jackh1999/ECE445/notebooks/pdfs/ESP Menu Screens.pdf

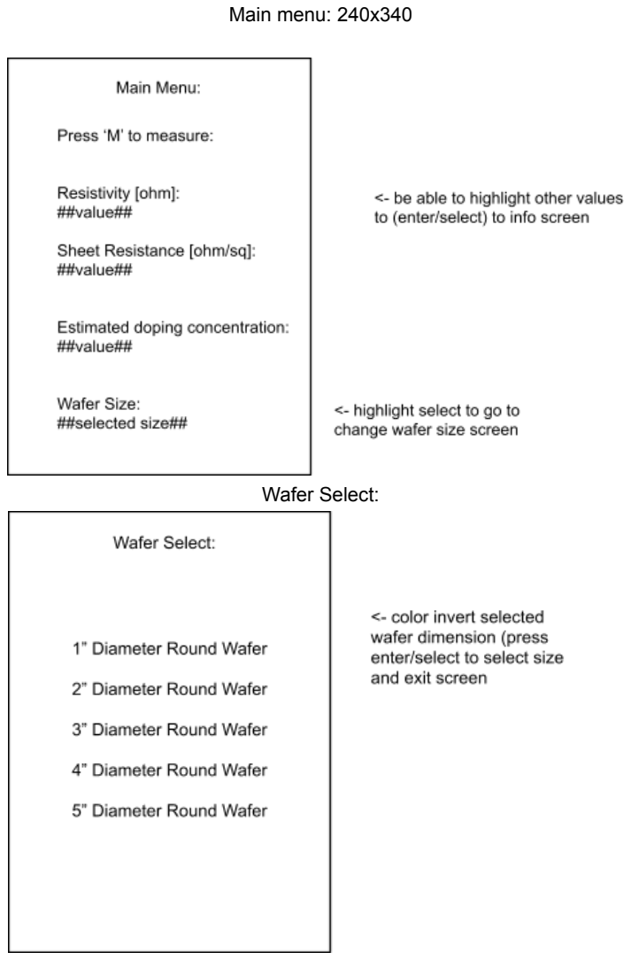
[picture p2: page 1]

Main menu: 240x340

Wafer Select:

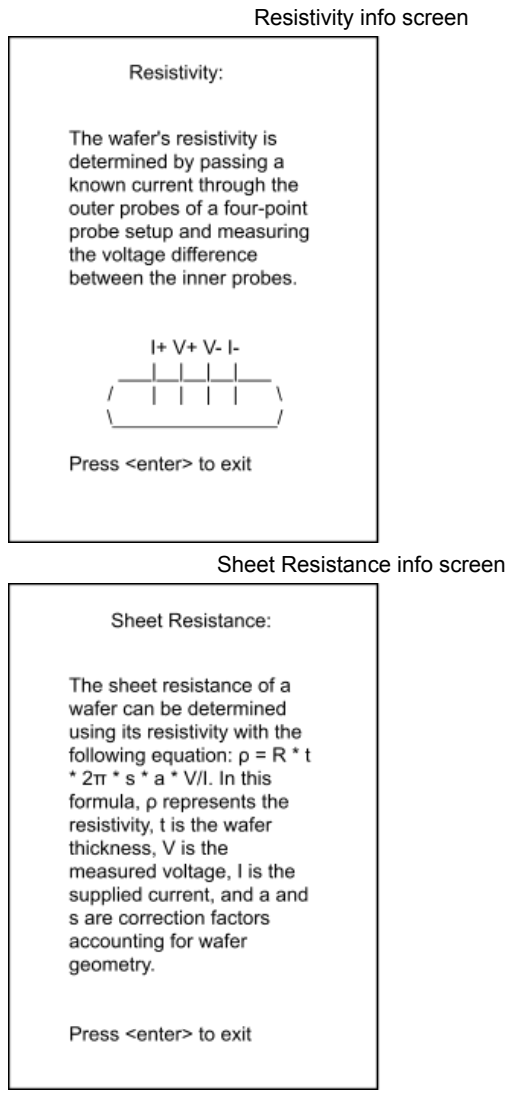
[picture p3: page 2]

Resistivity info screen

Sheet Resistance info screen

Estimated Doping Concentration:

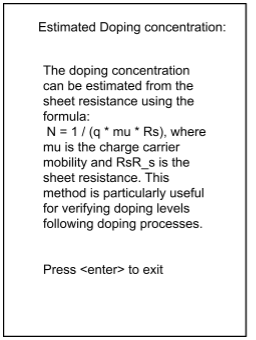
[picture p4: figure]
