jackh1999/ECE445/boards/PCB Round 1/FPP_10_8/FPP_10_8.kicad_pcb

## KiCad design boards/PCB Round 1/FPP_10_8/FPP_10_8.kicad_pcb (2024-12-03)

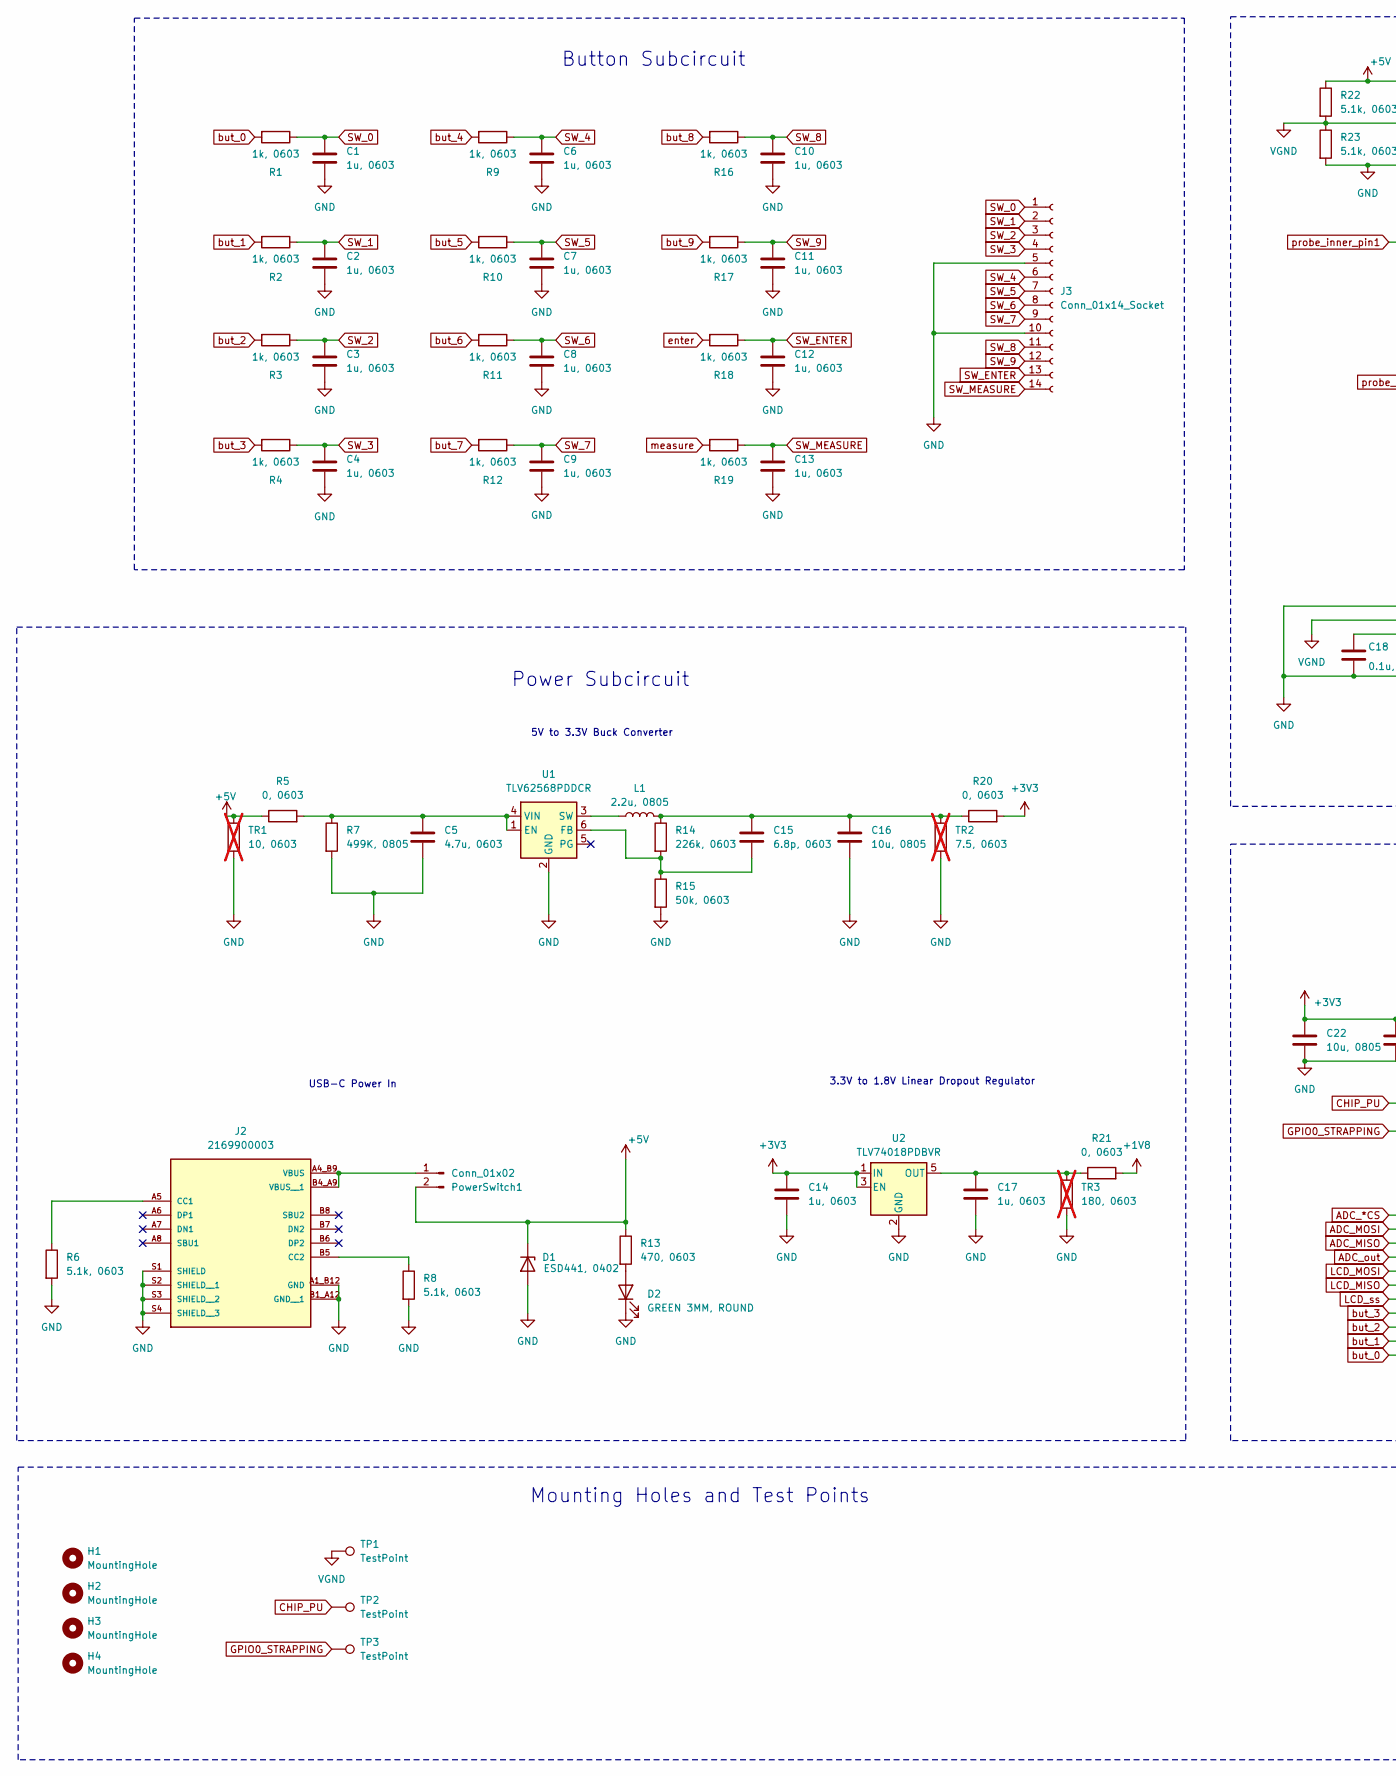
[picture p5: schematic FPP_10_8.kicad_sch, part in row 1, column 1]

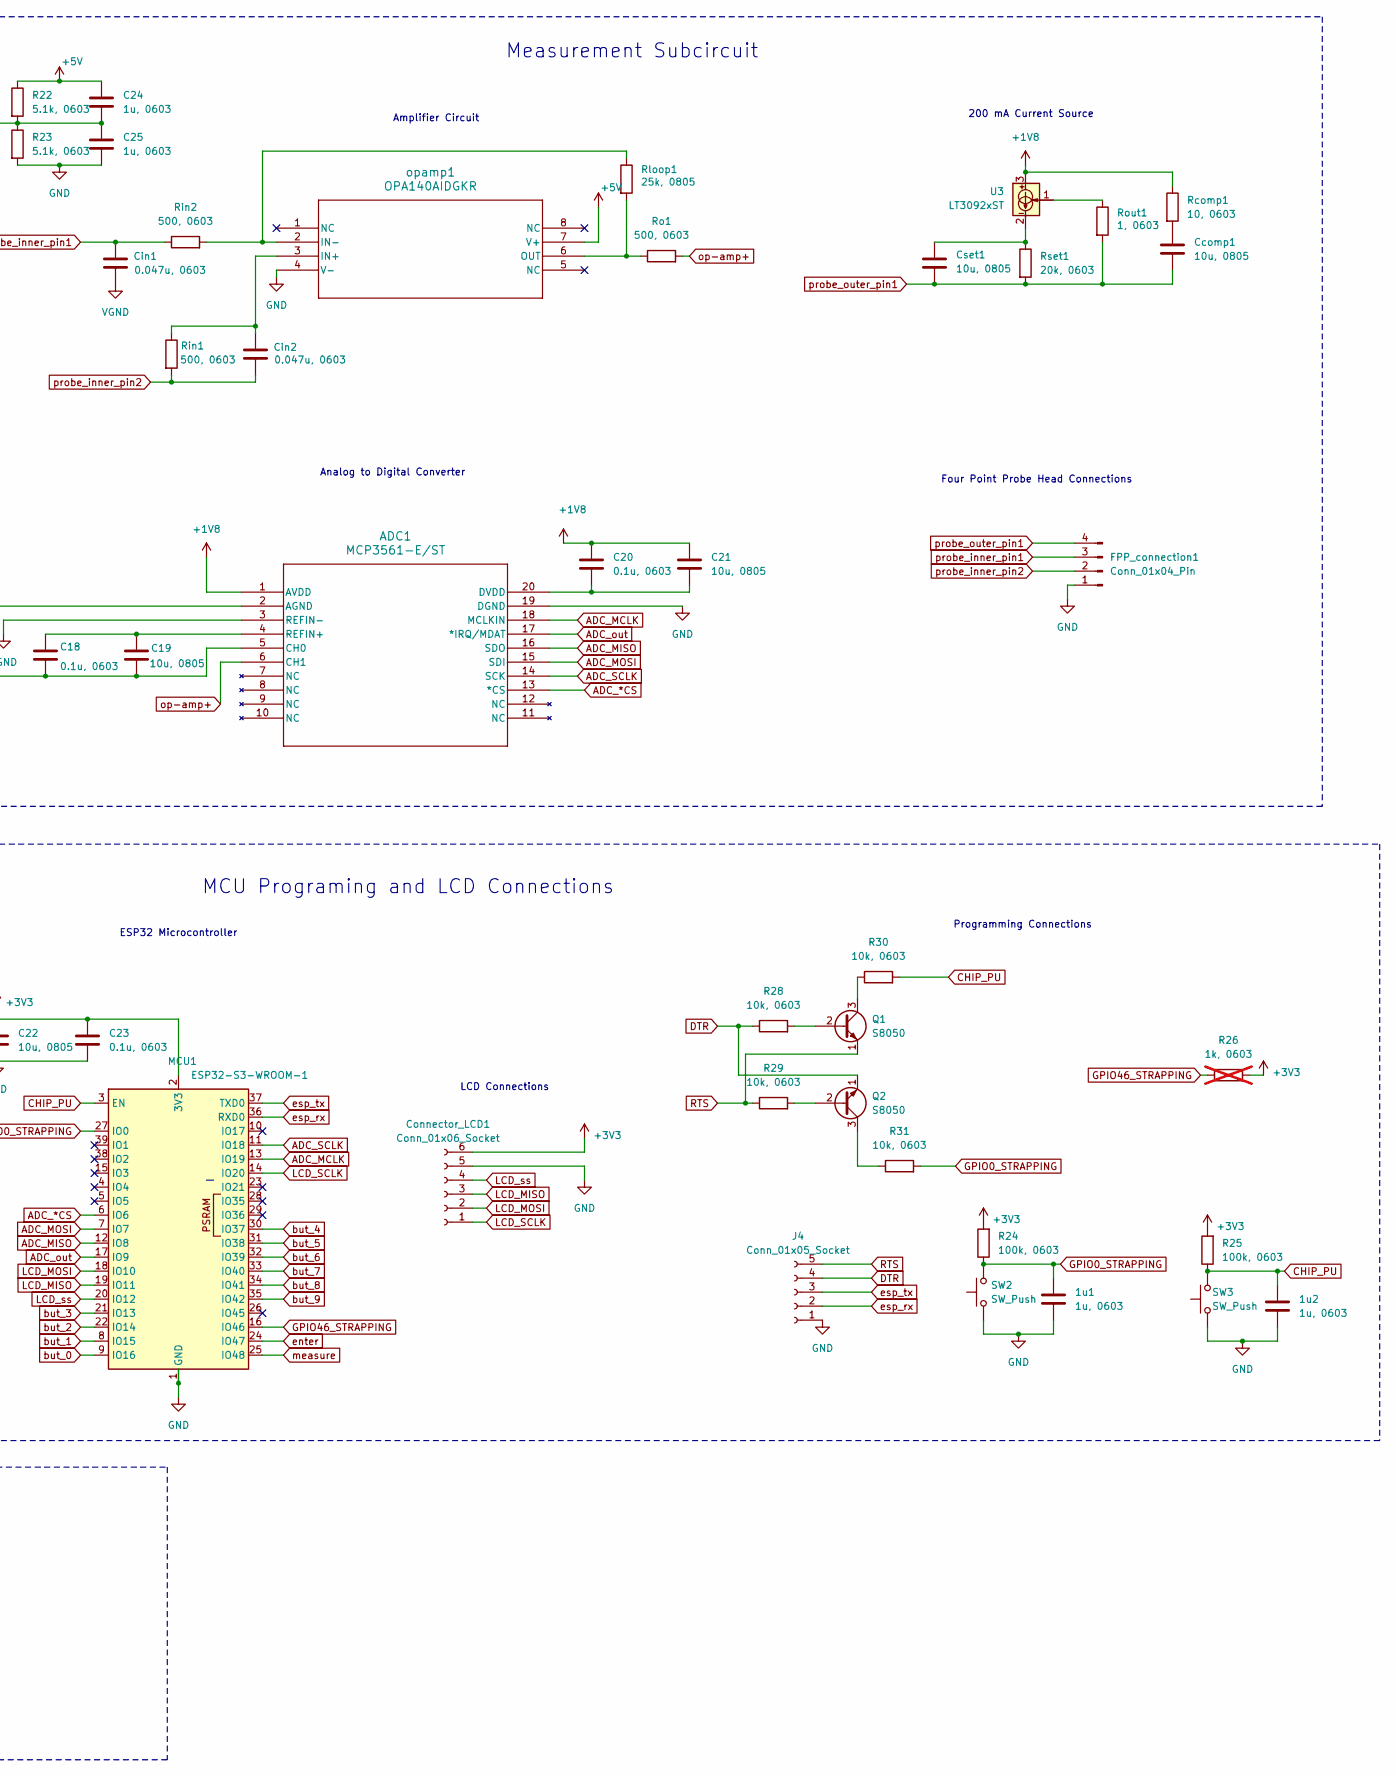
[picture p6: schematic FPP_10_8.kicad_sch, part in row 1, column 2]

Parts:
1u1, 1u2: 1u, 0603; R_0603_1608Metric_Pad0.98x0.95mm_HandSolder
ADC1: MCP3561-E/ST; TSSOP-20_4.4x6.5mm_P0.65mm
C1, C2, C3, C4, C6, C7, C8, C9, C10, C11, C12, C13, C14, C17, C24, C25: 1u, 0603; R_0603_1608Metric_Pad0.98x0.95mm_HandSolder
C5: 4.7u, 0603; R_0603_1608Metric_Pad0.98x0.95mm_HandSolder
C15: 6.8p, 0603; R_0603_1608Metric_Pad0.98x0.95mm_HandSolder
C16, C19, C21, C22: 10u, 0805; R_0805_2012Metric_Pad1.20x1.40mm_HandSolder
C18, C20, C23: 0.1u, 0603; R_0603_1608Metric_Pad0.98x0.95mm_HandSolder
Ccomp1: 10u, 0805; R_0805_2012Metric_Pad1.20x1.40mm_HandSolder
Cin1, Cin2: 0.047u, 0603; R_0603_1608Metric_Pad0.98x0.95mm_HandSolder
Connector_LCD1: Conn_01x06_Socket; PinSocket_1x06_P2.54mm_Vertical
Cset1: 10u, 0805; R_0805_2012Metric_Pad1.20x1.40mm_HandSolder
D1: ESD441, 0402; R_0402_1005Metric_Pad0.72x0.64mm_HandSolder
D2: GREEN 3MM, ROUND; WL-TMRC_3MM
FPP_connection1: Conn_01x04_Pin; PinHeader_1x04_P2.54mm_Vertical
H1, H2, H3, H4: MountingHole; MountingHole_4.3mm_M4
J2: 2169900003; MOLEX_2169900003; PARTREV A1
J3: Conn_01x14_Socket; PinSocket_2x07_P2.54mm_Vertical
J4: Conn_01x05_Socket; PinSocket_1x05_P2.54mm_Vertical
L1: 2.2u, 0805; R_0805_2012Metric_Pad1.20x1.40mm_HandSolder
MCU1: ESP32-S3-WROOM-1
PowerSwitch1: Conn_01x02; Molex_KK-254_AE-6410-02A_1x02_P2.54mm_Vertical
Q1, Q2: S8050; SOT-23-3
R1, R2, R3, R4, R9, R10, R11, R12, R16, R17, R18, R19: 1k, 0603; R_0603_1608Metric_Pad0.98x0.95mm_HandSolder
R5, R20, R21: 0, 0603; R_0603_1608Metric_Pad0.98x0.95mm_HandSolder
R6, R8, R22, R23: 5.1k, 0603; R_0603_1608Metric_Pad0.98x0.95mm_HandSolder
R7: 499K, 0805; R_0805_2012Metric_Pad1.20x1.40mm_HandSolder
R13: 470, 0603; R_0603_1608Metric_Pad0.98x0.95mm_HandSolder
R14: 226k, 0603; R_0603_1608Metric_Pad0.98x0.95mm_HandSolder
R15: 50k, 0603; R_0603_1608Metric_Pad0.98x0.95mm_HandSolder
R24, R25: 100k, 0603; R_0603_1608Metric_Pad0.98x0.95mm_HandSolder
R26: 1k, 0603; R_0603_1608Metric_Pad0.98x0.95mm_HandSolder; not fitted
R28, R29, R30, R31: 10k, 0603; R_0603_1608Metric_Pad0.98x0.95mm_HandSolder
Rcomp1: 10, 0603; R_0603_1608Metric_Pad0.98x0.95mm_HandSolder
Rin1, Rin2: 500, 0603; R_0603_1608Metric_Pad0.98x0.95mm_HandSolder
Rloop1: 25k, 0805; R_0805_2012Metric_Pad1.20x1.40mm_HandSolder
Ro1: 500, 0603; R_0603_1608Metric_Pad0.98x0.95mm_HandSolder
Rout1: 1, 0603; R_0603_1608Metric_Pad0.98x0.95mm_HandSolder
Rset1: 20k, 0603; R_0603_1608Metric_Pad0.98x0.95mm_HandSolder
SW2, SW3: SW_Push; SWITCH_03211B
TP1, TP2, TP3: TestPoint; TestPoint_Pad_1.5x1.5mm
TR1: 10, 0603; R_0603_1608Metric_Pad0.98x0.95mm_HandSolder; not fitted
TR2: 7.5, 0603; R_0603_1608Metric_Pad0.98x0.95mm_HandSolder; not fitted
TR3: 180, 0603; R_0603_1608Metric_Pad0.98x0.95mm_HandSolder; not fitted
U1: TLV62568PDDCR; SOT-23-6
U2: TLV74018PDBVR; SOT-23-5
U3: LT3092xST; SOT-223-3_TabPin2
opamp1: OPA140AIDGKR; DGK8

Connections:
+1V8: ADC1.1 (AVDD), C20.1, C21.1, R21.2, Rcomp1.1, U3.3
+3V3: C14.1, C22.1, C23.1, Connector_LCD1.6, MCU1.2 (3V3), R20.2, R24.2, R25.2, R26.2, U2.1 (IN), U2.3 (EN)
+5V: C24.1, D1.1 (K), PowerSwitch1.2, R5.1, R13.1, R22.1, TR1.2, opamp1.7 (V+)
ADC_*CS: ADC1.13 (*CS), MCU1.6 (IO6)
ADC_MCLK: ADC1.18 (MCLKIN), MCU1.13 (IO19)
ADC_MISO: ADC1.16 (SDO), MCU1.12 (IO8)
ADC_MOSI: ADC1.15 (SDI), MCU1.7 (IO7)
ADC_SCLK: ADC1.14 (SCK), MCU1.11 (IO18)
ADC_out: ADC1.17 (*IRQ/MDAT), MCU1.17 (IO9)
CHIP_PU: 1u2.1, MCU1.3 (EN), R25.1, R30.2, SW3.6, TP2.1
DTR: J4.4, Q2.1 (E), R28.1
GND: 1u1.2, 1u2.2, ADC1.2 (AGND), ADC1.5 (CH0), ADC1.19 (DGND), C1.2, C2.2, C3.2, C4.2, C5.2, C6.2, C7.2, C8.2, C9.2, C10.2, C11.2, C12.2, C13.2, C14.2, C16.2, C17.2, C18.2, C19.2, C22.2, C23.2, C25.2, Connector_LCD1.5, D1.2 (A), D2.1 (K), FPP_connection1.1, J2.A1_B12 (GND), J2.B1_A12 (GND__1), J2.S1 (SHIELD), J2.S2 (SHIELD__1), J2.S3 (SHIELD__2), J2.S4 (SHIELD__3), J3.5, J3.10, J4.1, MCU1.1 (GND), MCU1.40 (GND), MCU1.41 (GND), R6.2, R7.2, R8.2, R15.2, R23.2, SW2.1, SW3.1, TR1.1, TR2.1, TR3.1, U1.2 (GND), U2.2 (GND), opamp1.4 (V-)
GPIO0_STRAPPING: 1u1.1, MCU1.27 (IO0), R24.1, R31.2, SW2.6, TP3.1
GPIO46_STRAPPING: MCU1.16 (IO46), R26.1
LCD_MISO: Connector_LCD1.3, MCU1.19 (IO11)
LCD_MOSI: Connector_LCD1.2, MCU1.18 (IO10)
LCD_SCLK: Connector_LCD1.1, MCU1.14 (IO20)
LCD_ss: Connector_LCD1.4, MCU1.20 (IO12)
unnamed: ADC1.20 (DVDD), C20.2, C21.2
unnamed: ADC1.4 (REFIN+), C18.1, C19.1
unnamed: C15.1, C16.1, L1.2, R14.1, R20.1, TR2.2
unnamed: Ccomp1.1, Rcomp1.2
unnamed: Cset1.1, Rset1.1, U3.2
unnamed: D2.2 (A), R13.2
unnamed: J2.A5 (CC1), R6.1
unnamed: J2.B5 (CC2), R8.1
unnamed: J2.A4_B9 (VBUS), J2.B4_A9 (VBUS__1), PowerSwitch1.1
unnamed: Q1.2 (B), R28.2
unnamed: Q1.3 (C), R30.1
unnamed: Q2.2 (B), R29.2
unnamed: Q2.3 (C), R31.1
unnamed: Rout1.1, U3.1
unnamed: C5.1, R5.2, R7.1, U1.1 (EN), U1.4 (VIN)
unnamed: C15.2, R14.2, R15.1, U1.6 (FB)
unnamed: L1.1, U1.3 (SW)
unnamed: C17.1, R21.1, TR3.2, U2.5 (OUT)
unnamed: Cin2.2, Rin1.1, opamp1.3 (IN+)
unnamed: Rin2.2, Rloop1.1, opamp1.2 (IN-)
unnamed: Rloop1.2, Ro1.1, opamp1.6 (OUT)
RTS: J4.5, Q1.1 (E), R29.1
SW_0: C1.1, J3.1, R1.1
SW_1: C2.1, J3.2, R2.1
SW_2: C3.1, J3.3, R3.1
SW_3: C4.1, J3.4, R4.1
SW_4: C6.1, J3.6, R9.1
SW_5: C7.1, J3.7, R10.1
SW_6: C8.1, J3.8, R11.1
SW_7: C9.1, J3.9, R12.1
SW_8: C10.1, J3.11, R16.1
SW_9: C11.1, J3.12, R17.1
SW_ENTER: C12.1, J3.13, R18.1
SW_MEASURE: C13.1, J3.14, R19.1
VGND: ADC1.3 (REFIN-), C24.2, C25.1, Cin1.1, R22.2, R23.1, TP1.1
but_0: MCU1.9 (IO16), R1.2
but_1: MCU1.8 (IO15), R2.2
but_2: MCU1.22 (IO14), R3.2
but_3: MCU1.21 (IO13), R4.2
but_4: MCU1.30 (IO37), R9.2
but_5: MCU1.31 (IO38), R10.2
but_6: MCU1.32 (IO39), R11.2
but_7: MCU1.33 (IO40), R12.2
but_8: MCU1.34 (IO41), R16.2
but_9: MCU1.35 (IO42), R17.2
enter: MCU1.24 (IO47), R18.2
esp_rx: J4.2, MCU1.36 (RXD0)
esp_tx: J4.3, MCU1.37 (TXD0)
measure: MCU1.25 (IO48), R19.2
op-amp+: ADC1.6 (CH1), Ro1.2
probe_inner_pin1: Cin1.2, FPP_connection1.3, Rin2.1
probe_inner_pin2: Cin2.1, FPP_connection1.2, Rin1.2
probe_outer_pin1: Ccomp1.2, Cset1.2, FPP_connection1.4, Rout1.2, Rset1.2

Notes on the sheet:
USB-C Power In
ESP32 Microcontroller
Amplifier Circuit
3.3V to 1.8V Linear Dropout Regulator
200 mA Current Source
Four Point Probe Head Connections
Measurement Subcircuit
Analog to Digital Converter
Power Subcircuit
Button Subcircuit
LCD Connections
5V to 3.3V Buck Converter
MCU Programing and LCD Connections
Mounting Holes and Test Points
Programming Connections

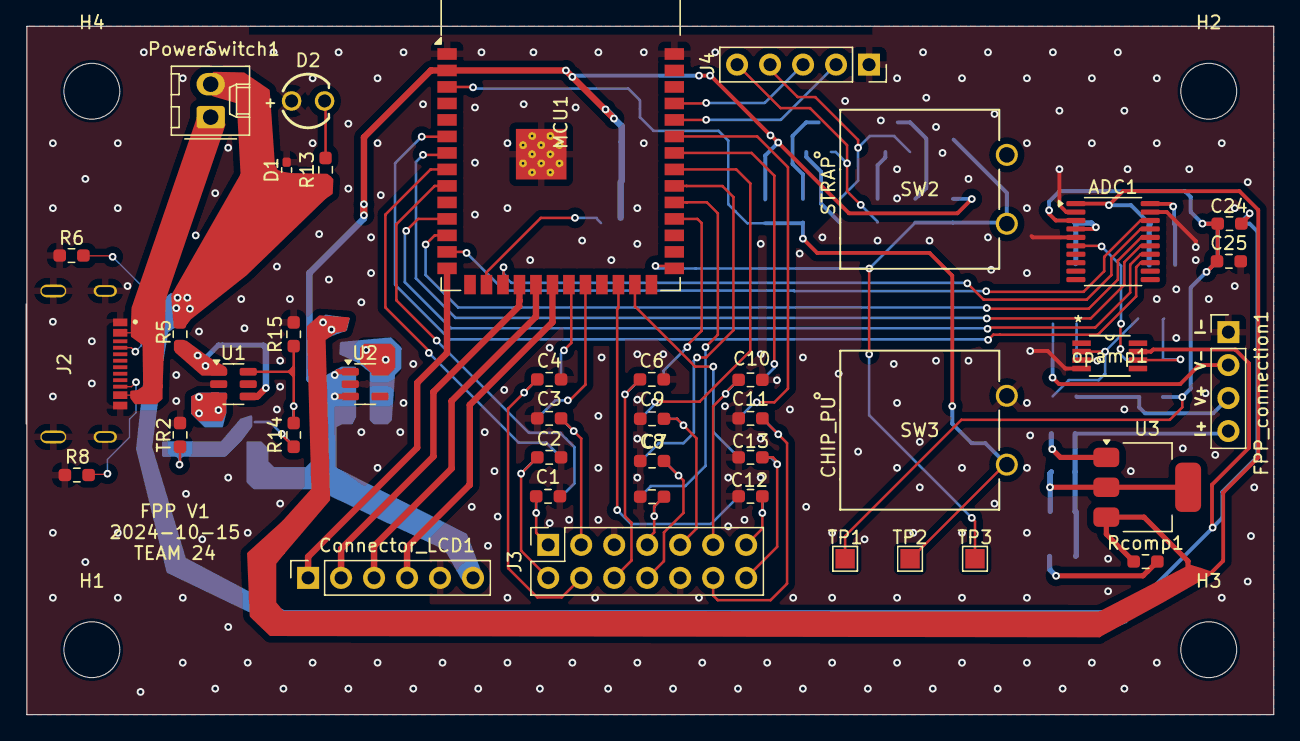
[picture p7: board FPP_10_8.kicad_pcb from above]

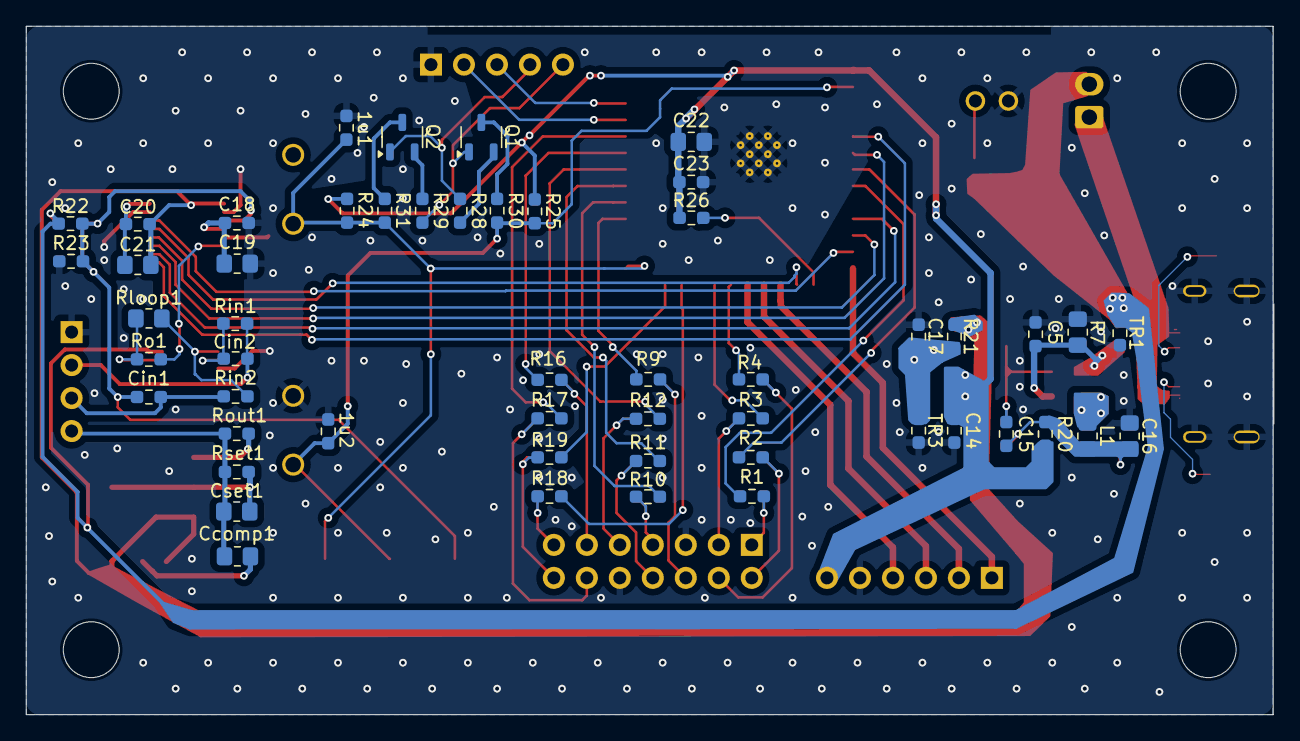
[picture p8: board FPP_10_8.kicad_pcb from below]

Board: 2 copper layers, 96.0 x 53.0 mm, 97 parts (52 on the bottom side), 71 nets.
