jackh1999/ECE445/models/Design Document (10-4)/FPP_10_4.kicad_sch

## KiCad design models/Design Document (10-4)/FPP_10_4.kicad_sch (2024-10-08)

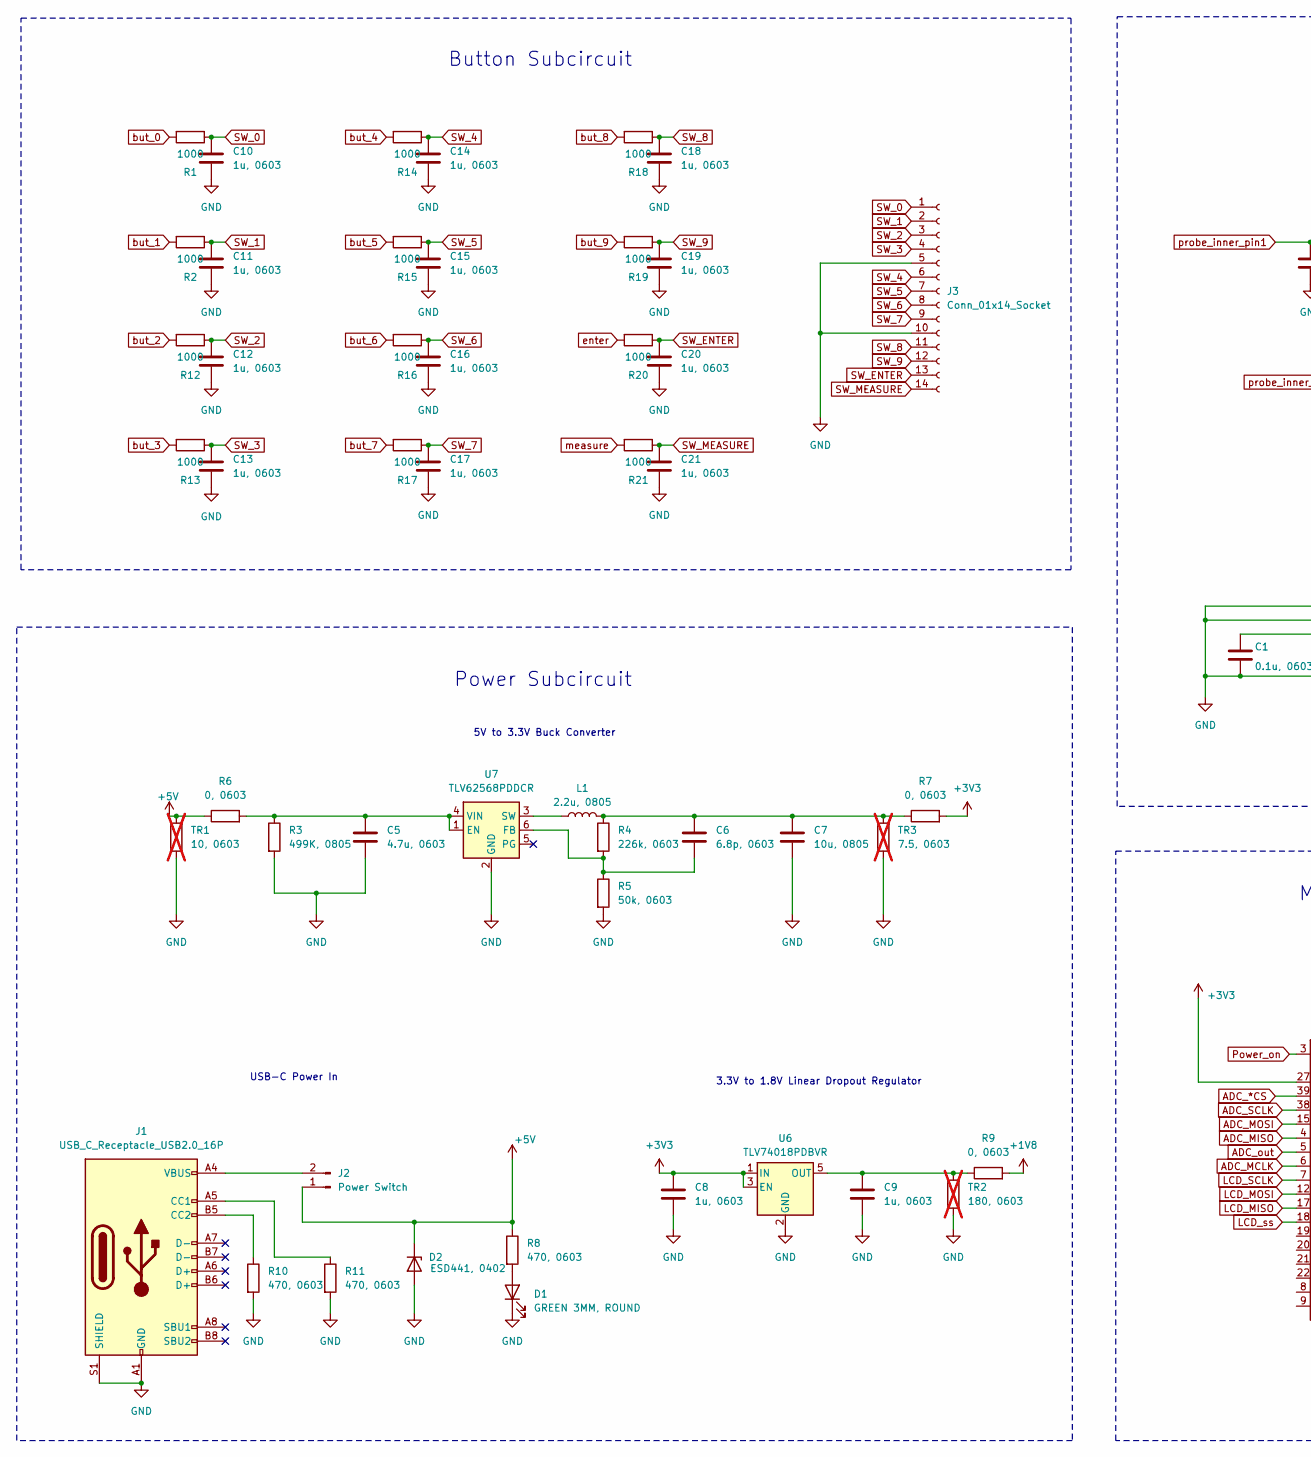
[picture p9: schematic FPP_10_4.kicad_sch, part in row 1, column 1]

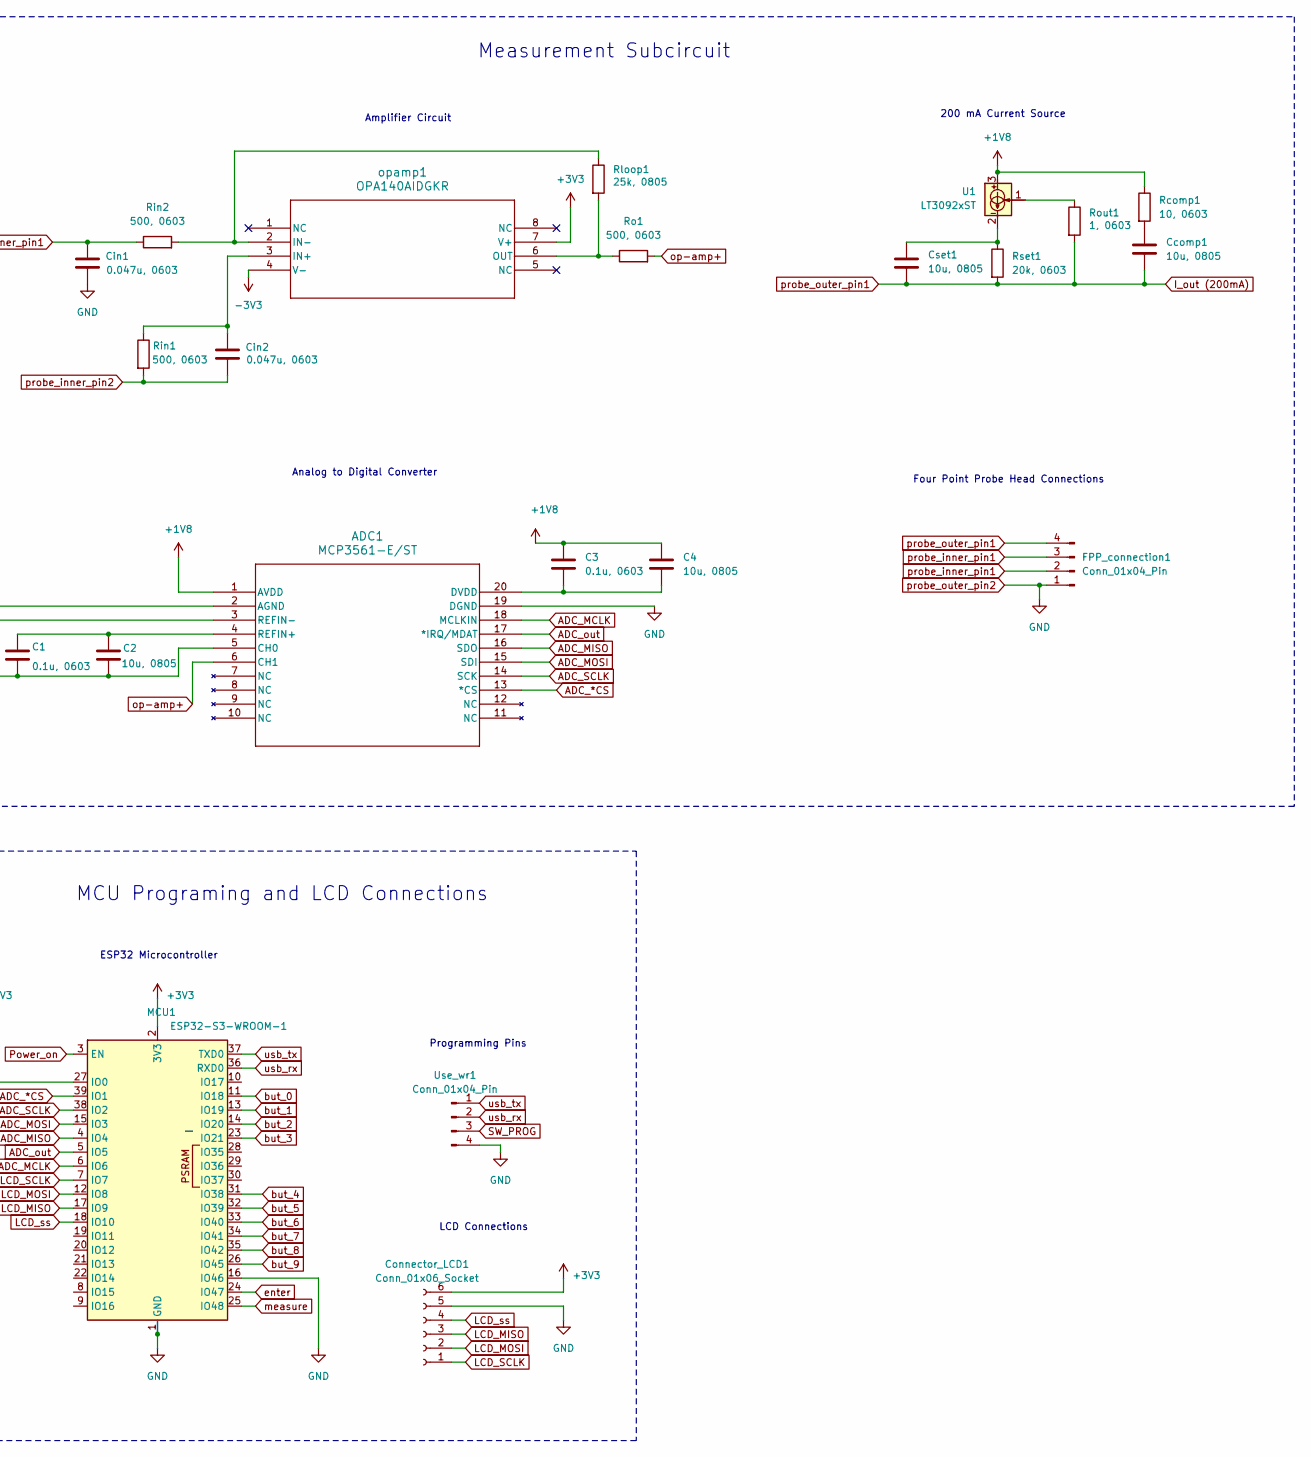
[picture p10: schematic FPP_10_4.kicad_sch, part in row 1, column 2]

Parts:
ADC1: MCP3561-E/ST; TSSOP20_ST_MCH
C1, C3: 0.1u, 0603
C2, C4, C7: 10u, 0805
C5: 4.7u, 0603
C6: 6.8p, 0603
C8, C9, C10, C11, C12, C13, C14, C15, C16, C17, C18, C19, C20, C21: 1u, 0603
Ccomp1: 10u, 0805
Cin1, Cin2: 0.047u, 0603
Connector_LCD1: Conn_01x06_Socket
Cset1: 10u, 0805
D1: GREEN 3MM, ROUND
D2: ESD441, 0402
FPP_connection1: Conn_01x04_Pin
J1: USB_C_Receptacle_USB2.0_16P
J2: Power Switch
J3: Conn_01x14_Socket
L1: 2.2u, 0805
MCU1: ESP32-S3-WROOM-1
R1, R2, R12, R13, R14, R15, R16, R17, R18, R19, R20, R21: 1000
R3: 499K, 0805; R_0805_2012Metric
R4: 226k, 0603; 0603
R5: 50k, 0603
R6, R7, R9: 0, 0603
R8, R10, R11: 470, 0603; 0603
Rcomp1: 10, 0603
Rin1, Rin2: 500, 0603
Rloop1: 25k, 0805
Ro1: 500, 0603
Rout1: 1, 0603
Rset1: 20k, 0603
TR1: 10, 0603; not fitted
TR2: 180, 0603; not fitted
TR3: 7.5, 0603; not fitted
U1: LT3092xST; SOT-223-3_TabPin2
U6: TLV74018PDBVR; SOT-23-5
U7: TLV62568PDDCR; SOT-23-6
Use_wr1: Conn_01x04_Pin
opamp1: OPA140AIDGKR; DGK8

Connections:
+1V8: ADC1.1 (AVDD), C3.1, C4.1, R9.2, Rcomp1.1, U1.3
+3V3: C8.1, Connector_LCD1.6, MCU1.2 (3V3), MCU1.27 (IO0), R7.2, U6.1 (IN), U6.3 (EN), opamp1.7 (V+)
+5V: D2.1 (K), J2.1, R6.1, R8.1, TR1.2
-3V3: opamp1.4 (V-)
ADC_*CS: ADC1.13 (*CS), MCU1.39 (IO1)
ADC_MCLK: ADC1.18 (MCLKIN), MCU1.6 (IO6)
ADC_MISO: ADC1.16 (SDO), MCU1.4 (IO4)
ADC_MOSI: ADC1.15 (SDI), MCU1.15 (IO3)
ADC_SCLK: ADC1.14 (SCK), MCU1.38 (IO2)
ADC_out: ADC1.17 (*IRQ/MDAT), MCU1.5 (IO5)
GND: ADC1.2 (AGND), ADC1.3 (REFIN-), ADC1.5 (CH0), ADC1.19 (DGND), C1.2, C2.2, C5.2, C7.2, C8.2, C9.2, C10.2, C11.2, C12.2, C13.2, C14.2, C15.2, C16.2, C17.2, C18.2, C19.2, C20.2, C21.2, Cin1.1, Connector_LCD1.5, D1.1 (K), D2.2 (A), FPP_connection1.1, J1.A1 (GND), J1.A12 (GND), J1.B1 (GND), J1.B12 (GND), J1.S1 (SHIELD), J3.5, J3.10, MCU1.1 (GND), MCU1.16 (IO46), MCU1.40 (GND), MCU1.41 (GND), R3.2, R5.2, R10.2, R11.2, TR1.1, TR2.1, TR3.1, U6.2 (GND), U7.2 (GND), Use_wr1.4
I_out (200mA): Ccomp1.2, Cset1.2, FPP_connection1.4, Rout1.2, Rset1.2
LCD_MISO: Connector_LCD1.3, MCU1.17 (IO9)
LCD_MOSI: Connector_LCD1.2, MCU1.12 (IO8)
LCD_SCLK: Connector_LCD1.1, MCU1.7 (IO7)
LCD_ss: Connector_LCD1.4, MCU1.18 (IO10)
unnamed: ADC1.4 (REFIN+), C1.1, C2.1
unnamed: ADC1.20 (DVDD), C3.2, C4.2
unnamed: C5.1, R3.1, R6.2, U7.1 (EN), U7.4 (VIN)
unnamed: C6.1, C7.1, L1.2, R4.1, R7.1, TR3.2
unnamed: C6.2, R4.2, R5.1, U7.6 (FB)
unnamed: C9.1, R9.1, TR2.2, U6.5 (OUT)
unnamed: Ccomp1.1, Rcomp1.2
unnamed: Cin2.2, Rin1.1, opamp1.3 (IN+)
unnamed: Cset1.1, Rset1.1, U1.2
unnamed: D1.2 (A), R8.2
unnamed: J1.A4 (VBUS), J1.A9 (VBUS), J1.B4 (VBUS), J1.B9 (VBUS), J2.2
unnamed: J1.A5 (CC1), R11.1
unnamed: J1.B5 (CC2), R10.1
unnamed: L1.1, U7.3 (SW)
unnamed: Rin2.2, Rloop1.1, opamp1.2 (IN-)
unnamed: Rloop1.2, Ro1.1, opamp1.6 (OUT)
unnamed: Rout1.1, U1.1
Power_on: MCU1.3 (EN)
SW_0: C10.1, J3.1, R1.1
SW_1: C11.1, J3.2, R2.1
SW_2: C12.1, J3.3, R12.1
SW_3: C13.1, J3.4, R13.1
SW_4: C14.1, J3.6, R14.1
SW_5: C15.1, J3.7, R15.1
SW_6: C16.1, J3.8, R16.1
SW_7: C17.1, J3.9, R17.1
SW_8: C18.1, J3.11, R18.1
SW_9: C19.1, J3.12, R19.1
SW_ENTER: C20.1, J3.13, R20.1
SW_MEASURE: C21.1, J3.14, R21.1
SW_PROG: Use_wr1.3
but_0: MCU1.11 (IO18), R1.2
but_1: MCU1.13 (IO19), R2.2
but_2: MCU1.14 (IO20), R12.2
but_3: MCU1.23 (IO21), R13.2
but_4: MCU1.31 (IO38), R14.2
but_5: MCU1.32 (IO39), R15.2
but_6: MCU1.33 (IO40), R16.2
but_7: MCU1.34 (IO41), R17.2
but_8: MCU1.35 (IO42), R18.2
but_9: MCU1.26 (IO45), R19.2
enter: MCU1.24 (IO47), R20.2
measure: MCU1.25 (IO48), R21.2
op-amp+: ADC1.6 (CH1), Ro1.2
probe_inner_pin1: Cin1.2, FPP_connection1.2, FPP_connection1.3, Rin2.1
probe_inner_pin2: Cin2.1, Rin1.2
usb_rx: MCU1.36 (RXD0), Use_wr1.2
usb_tx: MCU1.37 (TXD0), Use_wr1.1

Notes on the sheet:
LCD Connections
Measurement Subcircuit
Four Point Probe Head Connections
USB-C Power In
200 mA Current Source
MCU Programing and LCD Connections
Programming Pins
Button Subcircuit
Power Subcircuit
5V to 3.3V Buck Converter
3.3V to 1.8V Linear Dropout Regulator
Analog to Digital Converter
ESP32 Microcontroller
Amplifier Circuit
