jackh1999/ECE445/code/11-24 Code/ascii.c

#include "stdint.h"
#include <stdio.h>

uint8_t ASCII[96][12] = {
      {0x00,0x00,0x00,0x00,0x00,0x00,0x00,0x00,0x00,0x00,0x00,0x00},	//  
	  {0x00,0x30,0x78,0x78,0x78,0x30,0x30,0x00,0x30,0x30,0x00,0x00},	// !
	  {0x00,0x66,0x66,0x66,0x24,0x00,0x00,0x00,0x00,0x00,0x00,0x00},	// "
	  {0x00,0x6C,0x6C,0xFE,0x6C,0x6C,0x6C,0xFE,0x6C,0x6C,0x00,0x00},	// #
	  {0x30,0x30,0x7C,0xC0,0xC0,0x78,0x0C,0x0C,0xF8,0x30,0x30,0x00},	// $
	  {0x00,0x00,0x00,0xC4,0xCC,0x18,0x30,0x60,0xCC,0x8C,0x00,0x00},	// %
	  {0x00,0x70,0xD8,0xD8,0x70,0xFA,0xDE,0xCC,0xDC,0x76,0x00,0x00},	// &
	  {0x00,0x30,0x30,0x30,0x60,0x00,0x00,0x00,0x00,0x00,0x00,0x00},	// '
	  {0x00,0x0C,0x18,0x30,0x60,0x60,0x60,0x30,0x18,0x0C,0x00,0x00},	// (
	  {0x00,0x60,0x30,0x18,0x0C,0x0C,0x0C,0x18,0x30,0x60,0x00,0x00},	// )
	  {0x00,0x00,0x00,0x66,0x3C,0xFF,0x3C,0x66,0x00,0x00,0x00,0x00},	// *
	  {0x00,0x00,0x00,0x18,0x18,0x7E,0x18,0x18,0x00,0x00,0x00,0x00},	// +
	  {0x00,0x00,0x00,0x00,0x00,0x00,0x00,0x00,0x38,0x38,0x60,0x00},	// ,
	  {0x00,0x00,0x00,0x00,0x00,0xFE,0x00,0x00,0x00,0x00,0x00,0x00},	// -
	  {0x00,0x00,0x00,0x00,0x00,0x00,0x00,0x00,0x38,0x38,0x00,0x00},	// .
	  {0x00,0x00,0x02,0x06,0x0C,0x18,0x30,0x60,0xC0,0x80,0x00,0x00},	// /
	  {0x00,0x7C,0xC6,0xD6,0xD6,0xD6,0xD6,0xD6,0xC6,0x7C,0x00,0x00},	// 0
	  {0x00,0x10,0x30,0xF0,0x30,0x30,0x30,0x30,0x30,0xFC,0x00,0x00},	// 1
	  {0x00,0x78,0xCC,0xCC,0x0C,0x18,0x30,0x60,0xCC,0xFC,0x00,0x00},	// 2
	  {0x00,0x78,0xCC,0x0C,0x0C,0x38,0x0C,0x0C,0xCC,0x78,0x00,0x00},	// 3
	  {0x00,0x0C,0x1C,0x3C,0x6C,0xCC,0xFE,0x0C,0x0C,0x1E,0x00,0x00},	// 4
	  {0x00,0xFC,0xC0,0xC0,0xC0,0xF8,0x0C,0x0C,0xCC,0x78,0x00,0x00},	// 5
	  {0x00,0x38,0x60,0xC0,0xC0,0xF8,0xCC,0xCC,0xCC,0x78,0x00,0x00},	// 6
	  {0x00,0xFE,0xC6,0xC6,0x06,0x0C,0x18,0x30,0x30,0x30,0x00,0x00},	// 7
	  {0x00,0x78,0xCC,0xCC,0xEC,0x78,0xDC,0xCC,0xCC,0x78,0x00,0x00},	// 8
	  {0x00,0x78,0xCC,0xCC,0xCC,0x7C,0x18,0x18,0x30,0x70,0x00,0x00},	// 9
	  {0x00,0x00,0x00,0x38,0x38,0x00,0x00,0x38,0x38,0x00,0x00,0x00},	// :
	  {0x00,0x00,0x00,0x38,0x38,0x00,0x00,0x38,0x38,0x18,0x30,0x00},	// ;
	  {0x00,0x0C,0x18,0x30,0x60,0xC0,0x60,0x30,0x18,0x0C,0x00,0x00},	// <
	  {0x00,0x00,0x00,0x00,0x7E,0x00,0x7E,0x00,0x00,0x00,0x00,0x00},	// =
	  {0x00,0x60,0x30,0x18,0x0C,0x06,0x0C,0x18,0x30,0x60,0x00,0x00},	// >
	  {0x00,0x78,0xCC,0x0C,0x18,0x30,0x30,0x00,0x30,0x30,0x00,0x00},	// ?
	  {0x00,0x7C,0xC6,0xC6,0xDE,0xDE,0xDE,0xC0,0xC0,0x7C,0x00,0x00},	// @
	  {0x00,0x30,0x78,0xCC,0xCC,0xCC,0xFC,0xCC,0xCC,0xCC,0x00,0x00},	// A
	  {0x00,0xFC,0x66,0x66,0x66,0x7C,0x66,0x66,0x66,0xFC,0x00,0x00},	// B
	  {0x00,0x3C,0x66,0xC6,0xC0,0xC0,0xC0,0xC6,0x66,0x3C,0x00,0x00},	// C
	  {0x00,0xF8,0x6C,0x66,0x66,0x66,0x66,0x66,0x6C,0xF8,0x00,0x00},	// D
	  {0x00,0xFE,0x62,0x60,0x64,0x7C,0x64,0x60,0x62,0xFE,0x00,0x00},	// E
	  {0x00,0xFE,0x66,0x62,0x64,0x7C,0x64,0x60,0x60,0xF0,0x00,0x00},	// F
	  {0x00,0x3C,0x66,0xC6,0xC0,0xC0,0xCE,0xC6,0x66,0x3E,0x00,0x00},	// G
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
    };
