jackh1999/ECE445/(commit log)

2024-09-16 Create boards file
2024-12-05 Update README.md
    Printing Stuff
